roberttidey/CapacitorMeter/Docs/microUSBATTinyMod.jpg

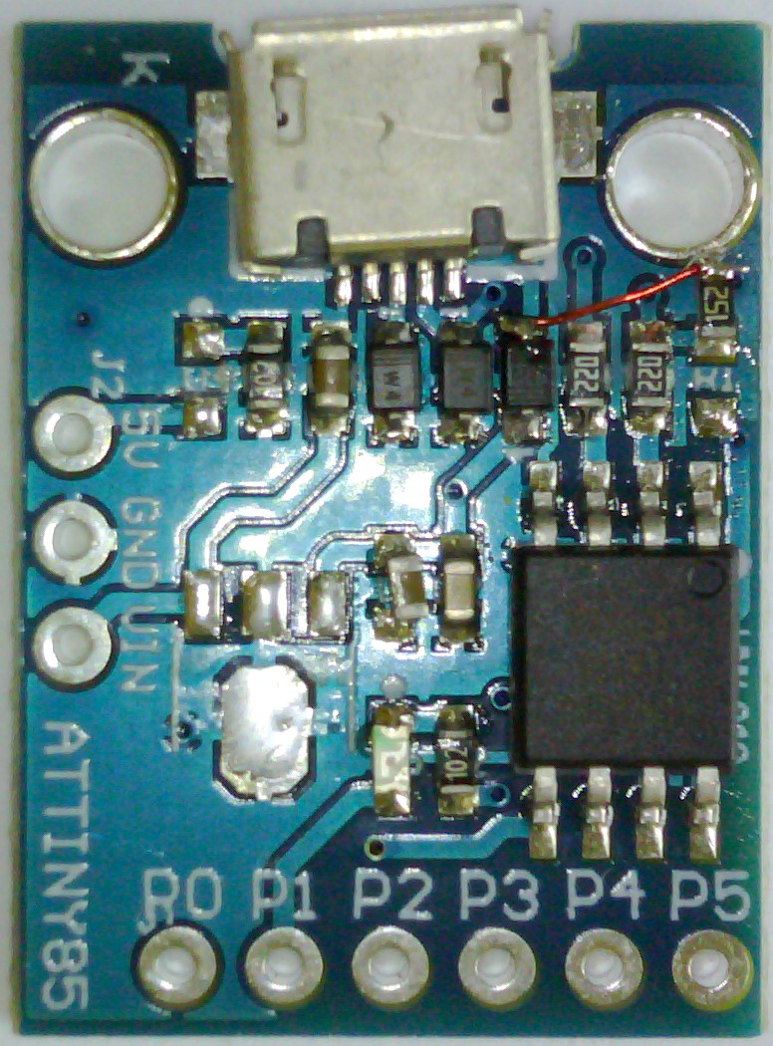
Docs/microUSBATTinyMod.jpg
