roberttidey/CapacitorMeter/Docs/CapacitorMeterSide.jpg

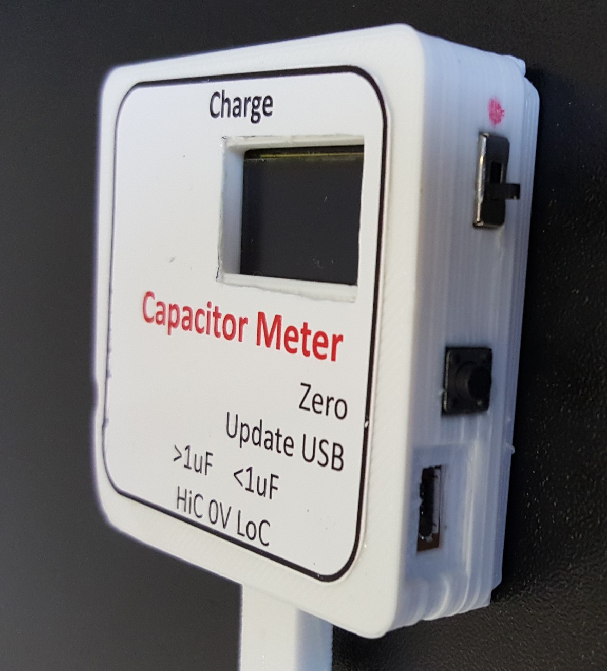
Docs/CapacitorMeterSide.jpg
