roberttidey/CapacitorMeter/Docs/ATTinyCapacitorMeterSchematic.jpg

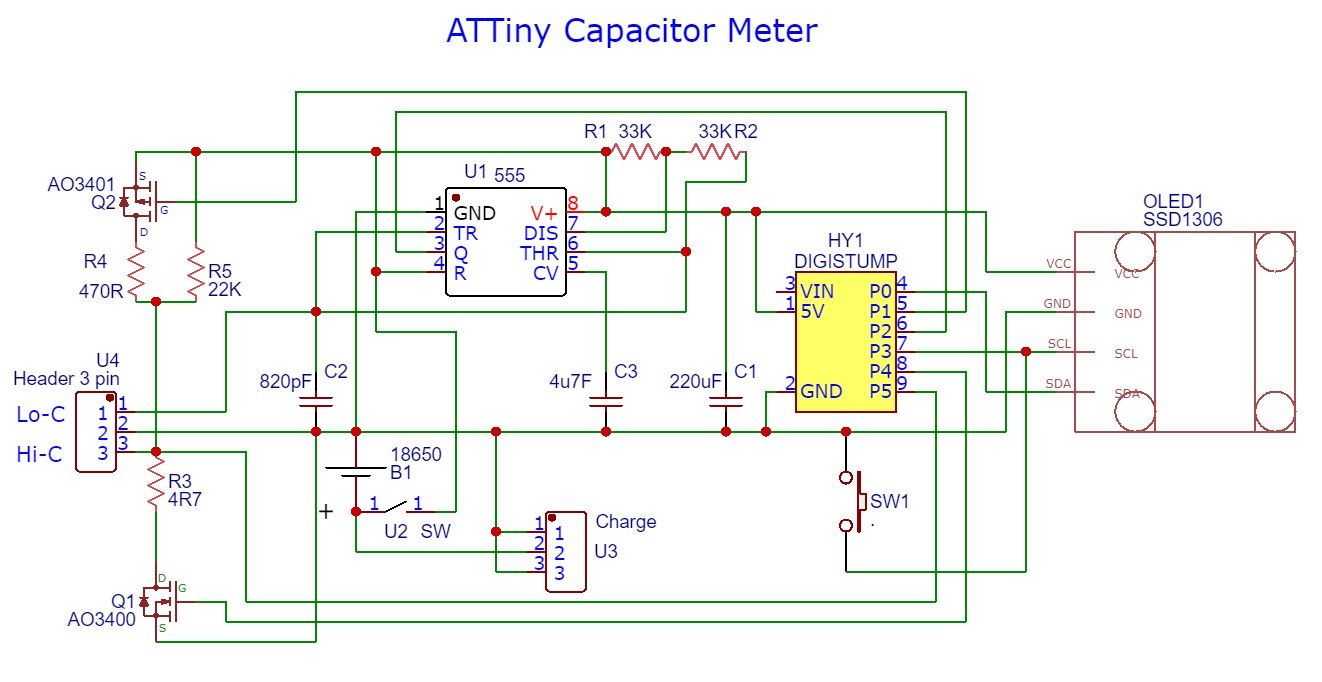
Docs/ATTinyCapacitorMeterSchematic.jpg
