roberttidey/CapacitorMeter/Docs/CapacitorMeterInternal.jpg

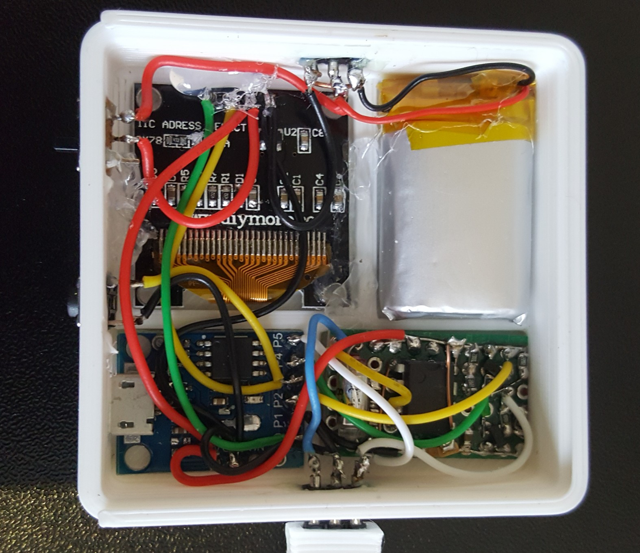
Docs/CapacitorMeterInternal.jpg
