roberttidey/CapacitorMeter/Docs/CapacitorMeterLabel.jpg

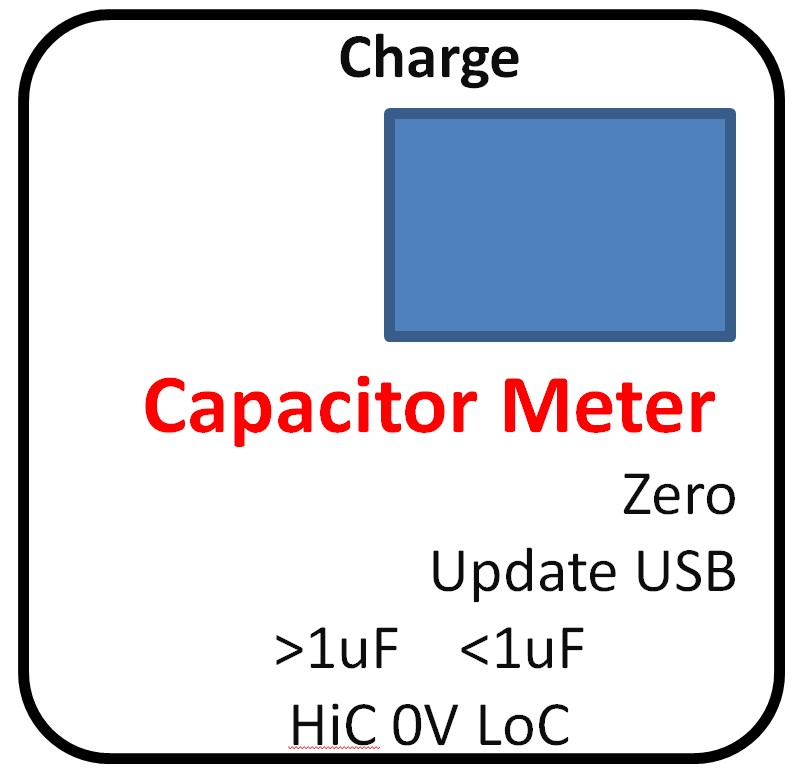
Docs/CapacitorMeterLabel.jpg
