roberttidey/CapacitorMeter/Docs/CapacitorMeterTop.jpg

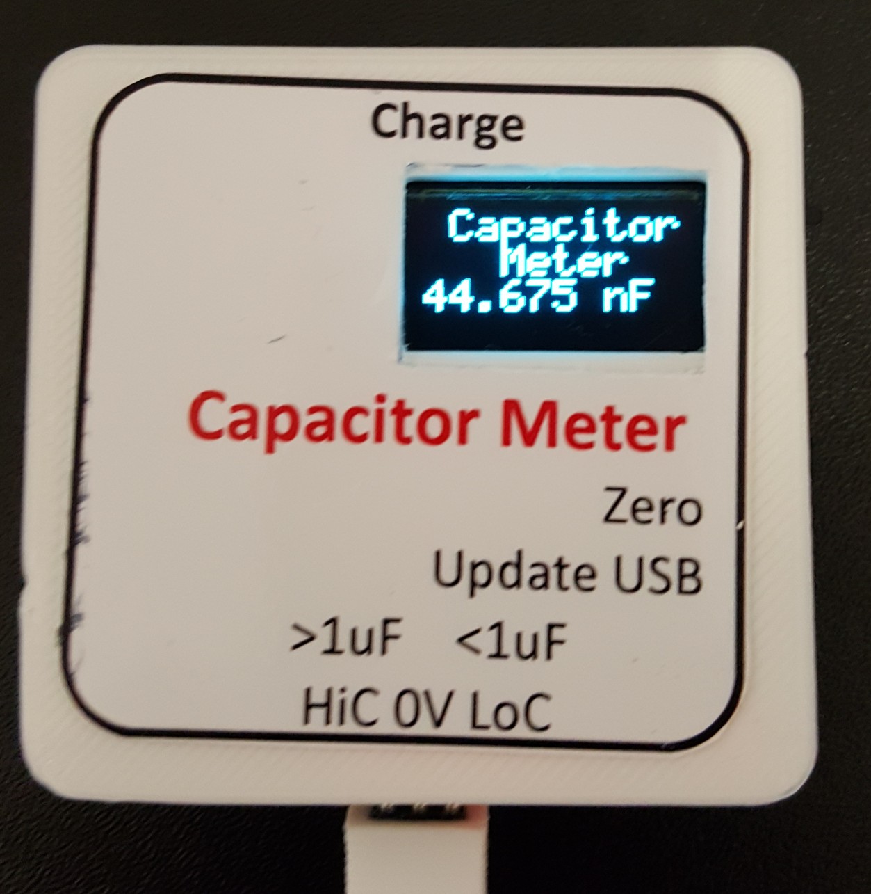
Docs/CapacitorMeterTop.jpg
