roberttidey/CapacitorMeter/(threads)

Thread 1 (2022-01-12):

Compile error __vector_5

vslinuxdotnet, 2022-01-12:
Hello,

I have a compile error in arduino:

wiring.c.o (symbol from plugin): In function `__vector_5':
(.text+0x0): multiple definition of `__vector_5'

This is because:

```
ISR(TIM0_OVF_vect) {
	overflowT0++;
}
```
If I comment it, works fine.

Any solution that you know ?

Regards.

roberttidey, 2022-01-13:
I'm not seeing that myself.

What version of Arduino are you using? Have you added the Digistump / Digispark support and selected the Digispark board.

E.g. Additional URL https://raw.githubusercontent.com/ArminJo/DigistumpArduino/master/package_digistump_index.json

vslinuxdotnet, 2022-01-13:
Im using AttinyCore from: https://github.com/SpenceKonde/ATTinyCore, is possible to change to timmer1 the ISR ?
Thank You.

roberttidey, 2022-01-13:
I think I remember having an issue with compilation using that core which I think was because the usage of the timers was different.

Changing timer is tricky due to the pin mapping of I/O. This was why I used the ArminJo version.

I have made a change to the code as I found later gcc compilers are fussier with use of global variables in inline asm but that doesn't having anything to do with your problem.
