roberttidey/CapacitorMeter/(commit log)

2022-01-13 FIx global reference in asm version which more recent compilers require.
    [CapacitorMeter.ino]
2023-07-22 Correct measuremt time for charging
    [CapacitorMeter.ino]
